mplsartindustry/kicad-libraries/README.md

# kicad-libraries

Common library for KiCAD components

Due to KiCAD not allowing relative paths to 3D models in footprints, the contents of
this repository should be included in a directory named `kicad-libraries` within the
project root directory (`${KIPRJMOD}`).
