mplsartindustry/kicad-libraries/3dmodels-src/README.md

# FreeCAD source files for 3D models

These files were created with FreeCAD 1.0.2, they may break if opened in a different version

## Common material colors

Silver metal:
- Ambient: #54423b
- Diffuse: #d2d1c7
- Emissive: #000000
- Specular: #f2ba00
- Shininess: 93%
