mplsartindustry/kicad-libraries/footprints-src/MAI_Logo/README.md

# Logo

To create a new logo footprint:

1. Create a new footprint in Footprint Editor
2. File > Import... > Graphics
3. Set scale for desired size, scale factor is 0.0288*(width in mm)
4. Place logo anywhere
5. Select the logo group, then press Shift+P, select "Use Local Origin", and position at 0, 0
6. In footprint properties, uncheck Show for reference and value text
