mplsartindustry/kicad-libraries/3dmodels-src/MAI_Button_Switch_THT/SW_Taiway_200-MSPx_SPDT_THT.FCStd

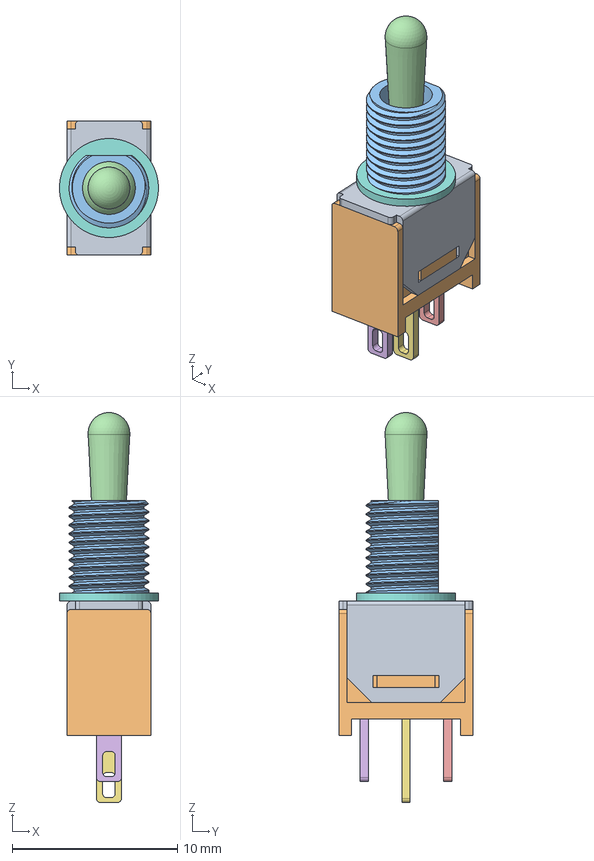
[picture p1: CAD file, 2026-05-24]
3dmodels-src/MAI_Button_Switch_THT/SW_Taiway_200-MSPx_SPDT_THT.FCStd
5.99 x 8.13 x 23.6 mm
Shaft
Lever
Pin 1
Pin 3
Pin 2
Bushing
