mplsartindustry/kicad-libraries/3dmodels-src/MAI_Connector_Audio/PJ301BM.FCStd

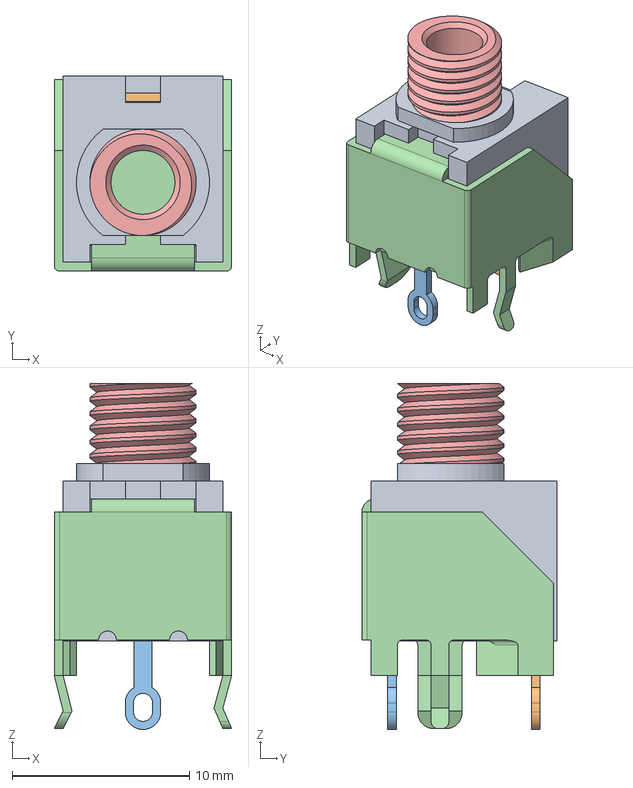
[picture p2: CAD file, 2025-09-27]
3dmodels-src/MAI_Connector_Audio/PJ301BM.FCStd
10.0 x 11.0 x 19.5 mm
Tip
Tip-Normal
Sleeve
Shaft
