mplsartindustry/kicad-libraries/3dmodels-src/MAI_Connector_SameSky/SameSky_TB010-508-02BE.FCStd

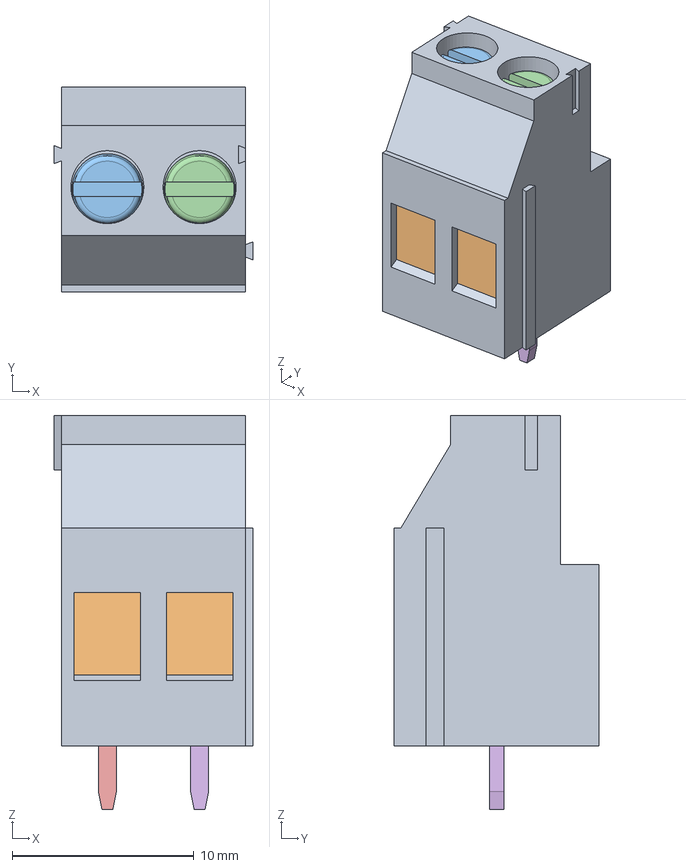
[picture p3: CAD file, 2026-01-01]
3dmodels-src/MAI_Connector_SameSky/SameSky_TB010-508-02BE.FCStd
11.0 x 11.3 x 21.7 mm
Inside
Screw
Screw2
Pin
Pin2
