mplsartindustry/kicad-libraries/3dmodels-src/MAI_Display_7Segment/BA56-11xxWA.FCStd

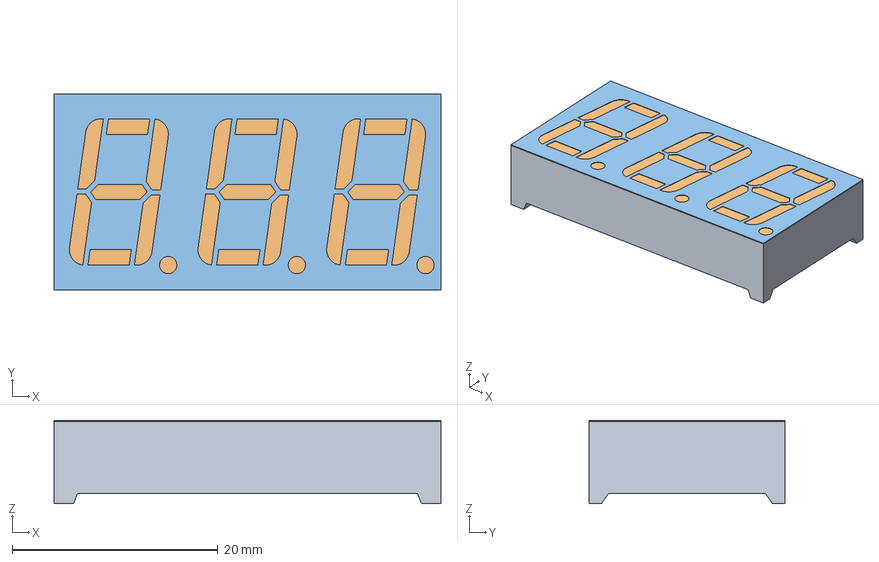
[picture p4: CAD file, 2025-09-26]
3dmodels-src/MAI_Display_7Segment/BA56-11xxWA.FCStd
37.6 x 19.0 x 8.10 mm
Display-Green-G
