mplsartindustry/kicad-libraries/3dmodels-src/MAI_Mounting_Wuerth/Mounting_Wuerth_WP-SMBU-M4_H7mm_ThreadDepth4mm_NoNPTH_7466204.FCStd

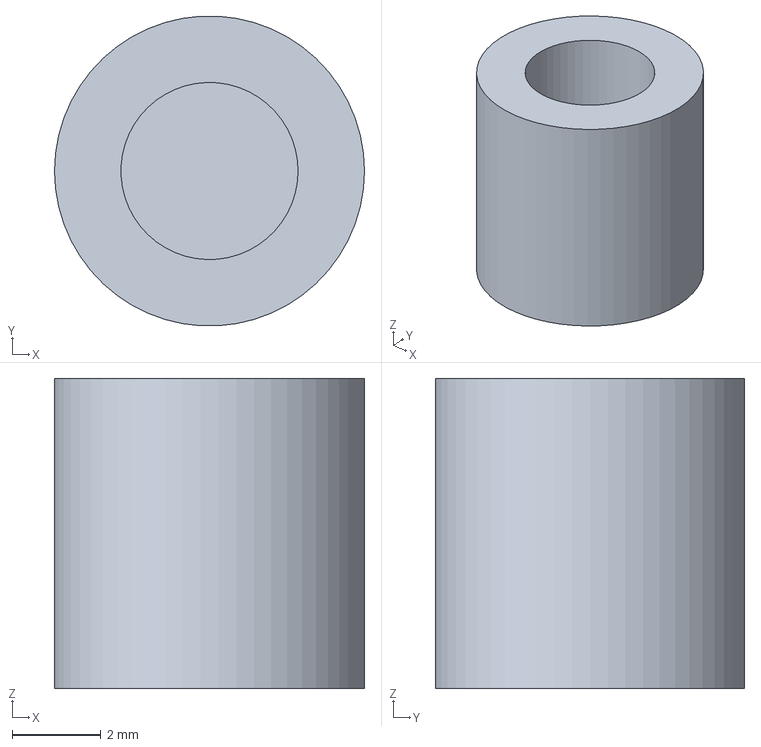
[picture p5: CAD file, 2026-01-01]
3dmodels-src/MAI_Mounting_Wuerth/Mounting_Wuerth_WP-SMBU-M4_H7mm_ThreadDepth4mm_NoNPTH_7466204.FCStd
7.00 x 6.99 x 7.00 mm
