mplsartindustry/kicad-libraries/3dmodels-src/MAI_Potentiometer_THT/Potentiometer_Alpha_RD901F-40-00D_Single_Vertical.FCStd

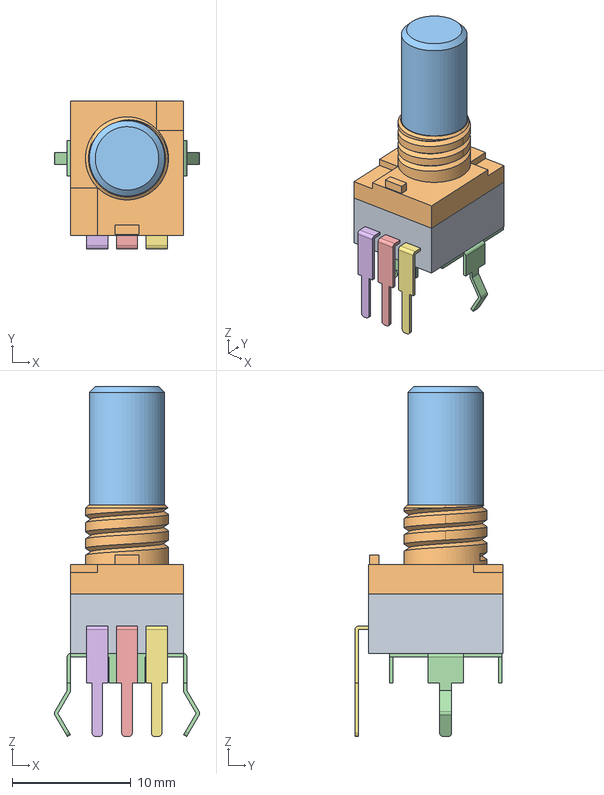
[picture p6: CAD file, 2026-03-23]
3dmodels-src/MAI_Potentiometer_THT/Potentiometer_Alpha_RD901F-40-00D_Single_Vertical.FCStd
12.3 x 12.5 x 29.5 mm
Body (Plastic)
Body (Metal)
Shaft
Mounting Pins
Pin 2
Pin 1
Pin 3
