mplsartindustry/kicad-libraries/3dmodels-src/MAI_Button_Switch_THT/SW_Taiway_100-SPx_SPDT_THT.FCStd

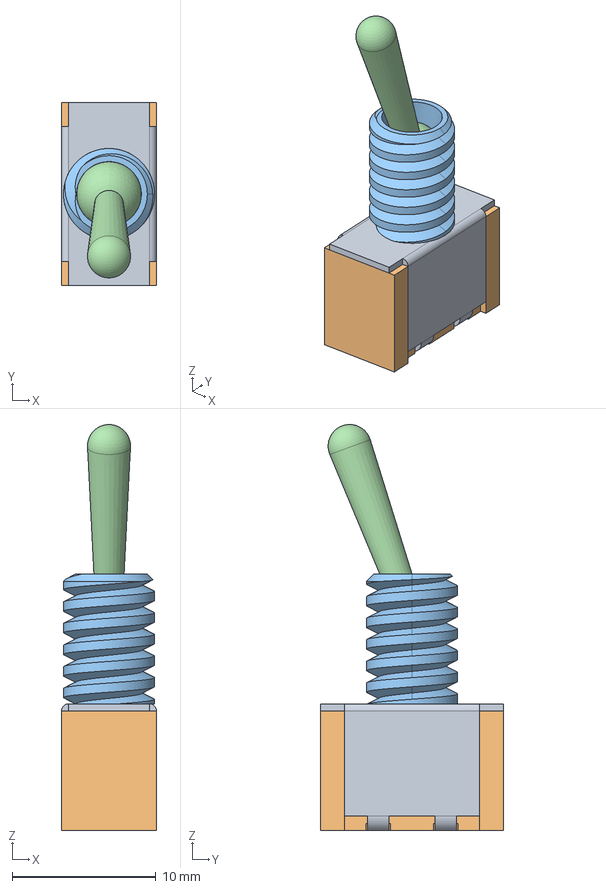
[picture p7: CAD file, 2025-11-10]
3dmodels-src/MAI_Button_Switch_THT/SW_Taiway_100-SPx_SPDT_THT.FCStd
6.60 x 12.7 x 28.2 mm
Shaft
Lever
