mplsartindustry/kicad-libraries/3dmodels-src/MAI_Potentiometer_THT/Potentiometer_Bourns_PV36X_Horizontal.FCStd

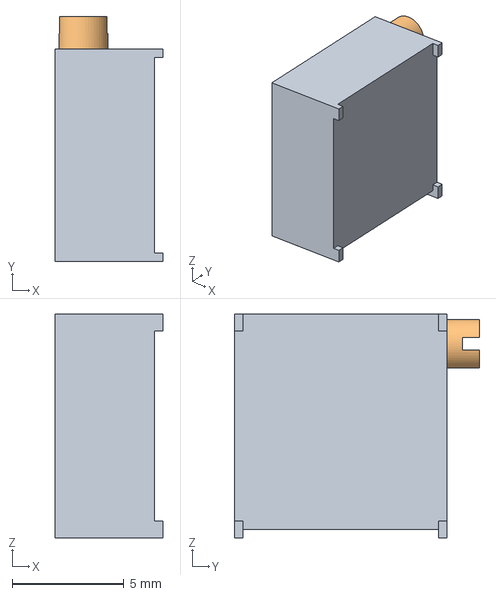
[picture p8: CAD file, 2026-01-02]
3dmodels-src/MAI_Potentiometer_THT/Potentiometer_Bourns_PV36X_Horizontal.FCStd
4.83 x 11.0 x 10.0 mm
Dial
