mplsartindustry/kicad-libraries/3dmodels-src/MAI_Button_Switch_THT/SW_CK_D6Rxx_SPST.FCStd

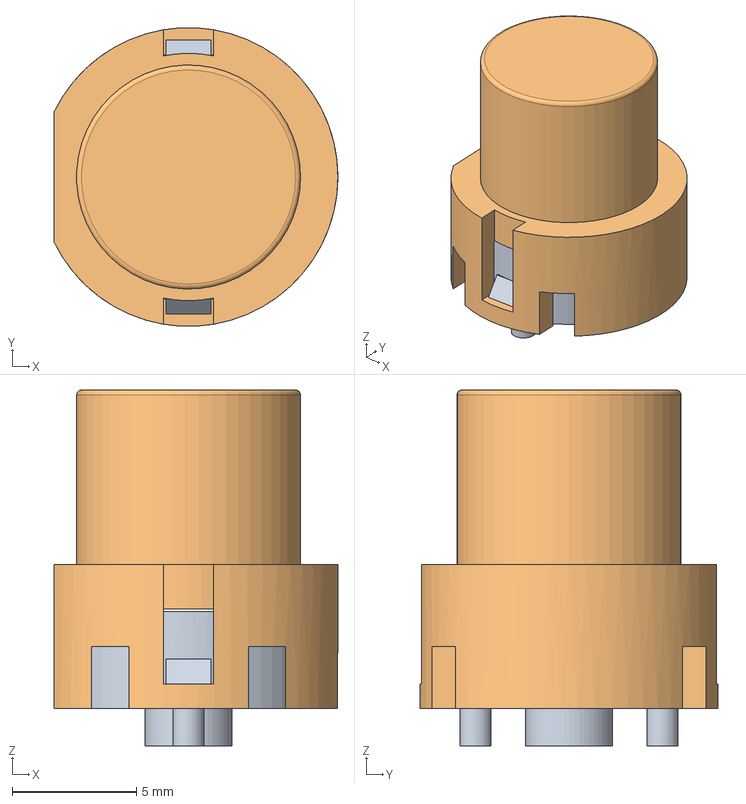
[picture p9: CAD file, 2025-09-26]
3dmodels-src/MAI_Button_Switch_THT/SW_CK_D6Rxx_SPST.FCStd
11.4 x 12.0 x 14.3 mm
Switch
Button-Blue-60
