mplsartindustry/kicad-libraries/3dmodels-src/MAI_Potentiometer_THT/Potentiometer_Bourns_PV36W_Vertical.FCStd

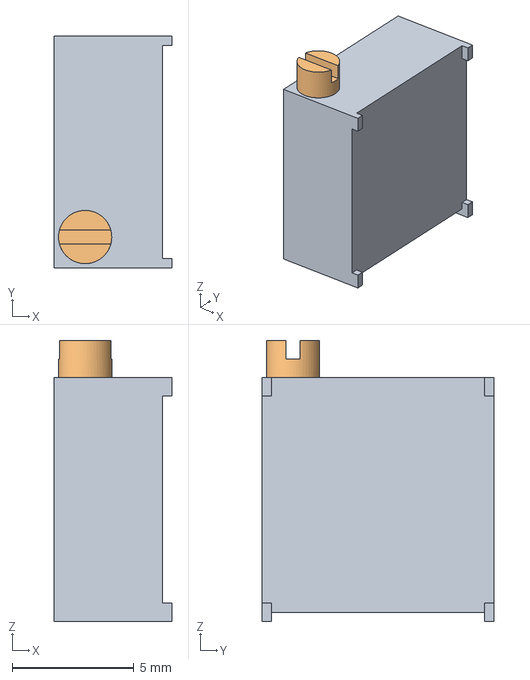
[picture p10: CAD file, 2025-11-10]
3dmodels-src/MAI_Potentiometer_THT/Potentiometer_Bourns_PV36W_Vertical.FCStd
4.83 x 9.53 x 11.5 mm
Dial
