mplsartindustry/kicad-libraries/3dmodels-src/MAI_Potentiometer_THT/Potentiometer_Slide_Bourns_PTL45-15xx_60mm.FCStd

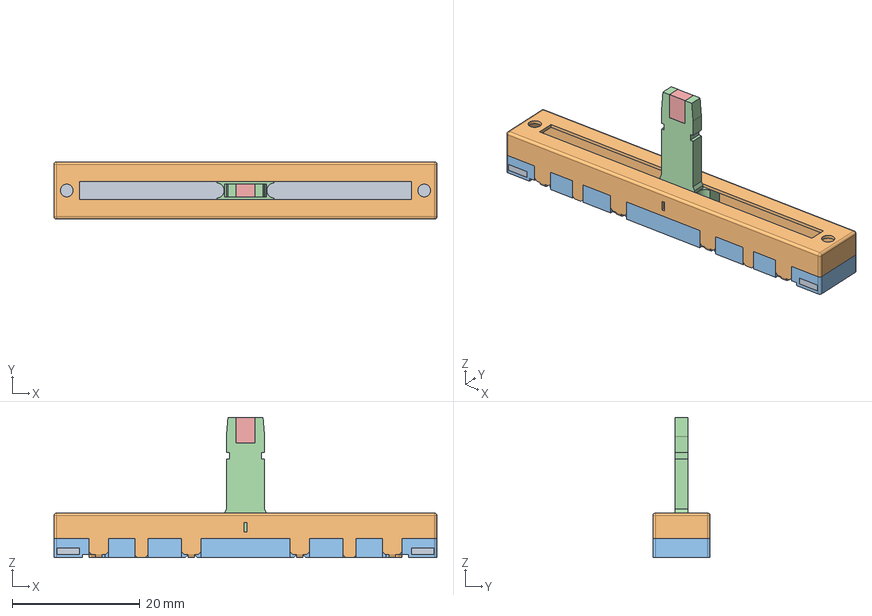
[picture p11: CAD file, 2025-11-10]
3dmodels-src/MAI_Potentiometer_THT/Potentiometer_Slide_Bourns_PTL45-15xx_60mm.FCStd
60.0 x 9.00 x 22.0 mm
Substrate
Case
Lever
LED
