mplsartindustry/kicad-libraries/(commit log)

2025-09-27 Add PJ301BM jacks and DIP sockets with chip
2025-09-28 Add panel holes and logo
2025-10-01 Add Teensy 4.0
2025-10-04 Fix BA56-11xxWA schematic symbol
2025-11-03 Add schematic symbol for AS3364
2025-11-05 Add footprint for Adafruit slide pot
2025-11-10 Add Bourns PTL45-15xx slide pot with LED
2025-11-10 Add model and footprint for Taiway SPDT toggle switch
2025-11-10 Add model and footprint for Bourns PV36W trimpot
2025-11-12 Add some more panel holes
2025-11-19 Add 6mm silkscreen logo
2026-01-01 Add panel hole footprint for Bourns PTL45-15xx
2026-01-01 Add Wuerth 7466204 SMT standoff
2026-01-01 Add courtyard bounds to all panel hole footprints
2026-03-23 Add footprints and model for Alpha PCB-mount pots
2026-03-23 Remove library extensions from folders that aren't libraries
    [BA56-11xxWA.FCStd, Mounting_Wuerth_WP-SMBU-M4_H7mm_ThreadDepth4mm_NoNPTH_7466204.FCStd, PJ301BM.FCStd, Potentiometer_Alpha_RD901F-40-00D_Single_Vertical.FCStd, Potentiometer_Bourns_PV36W_Vertical.FCStd, Potentiometer_Bourns_PV36X_Horizontal.FCStd, Potentiometer_Slide_Bourns_PTL45-15xx_60mm.FCStd, SW_CK_D6Rxx_SPST.FCStd]
2026-05-18 Add symbol for SP8T rotary switch without mounting point
2026-05-18 Add footprint for Adafruit SP8T rotary switch
2026-05-18 Add symbol for 8-bit R2R resistor pack
2026-05-18 Add footprint for DIP-20 chip in socket
2026-05-24 Add footprint, model, and panel hole for Taiway 200-MSPx series switches
    [SW_Taiway_200-MSPx_SPDT_THT.FCStd]
